bartoszp1992/Spinner/doc/assembly/bottom.jpg

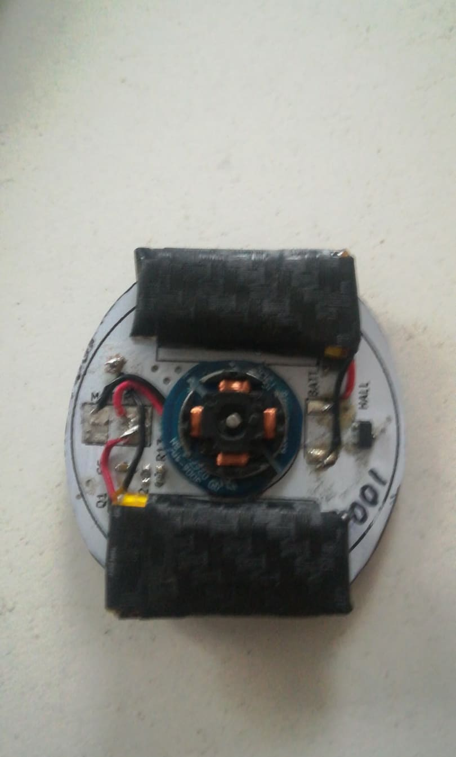
doc/assembly/bottom.jpg
