bartoszp1992/Spinner/doc/assembly/magnets.jpg

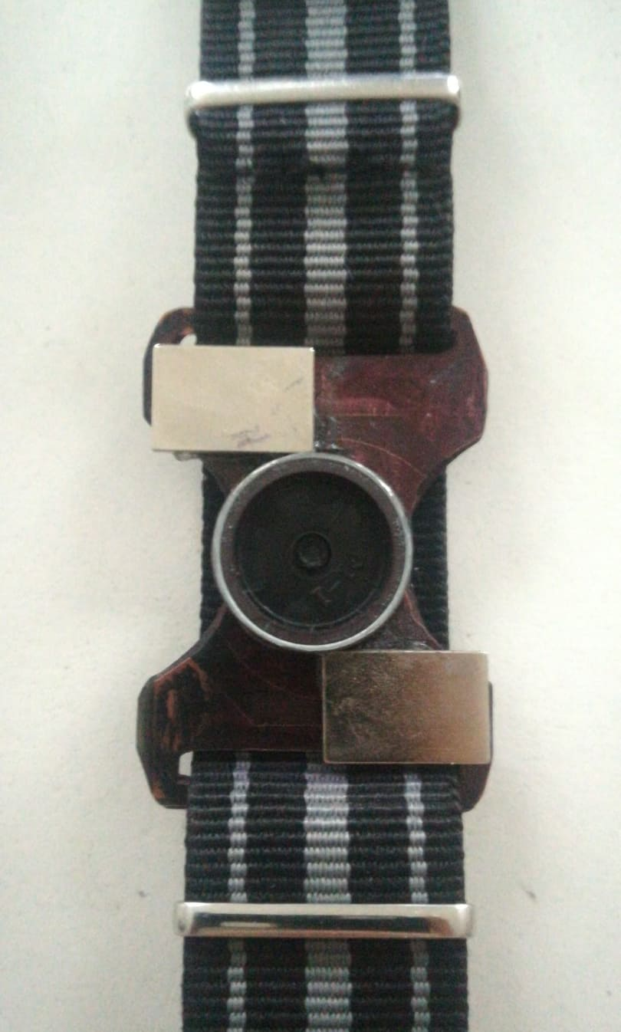
doc/assembly/magnets.jpg
