bartoszp1992/Spinner/doc/pcb/synchro mk2/synchro_mk2.step

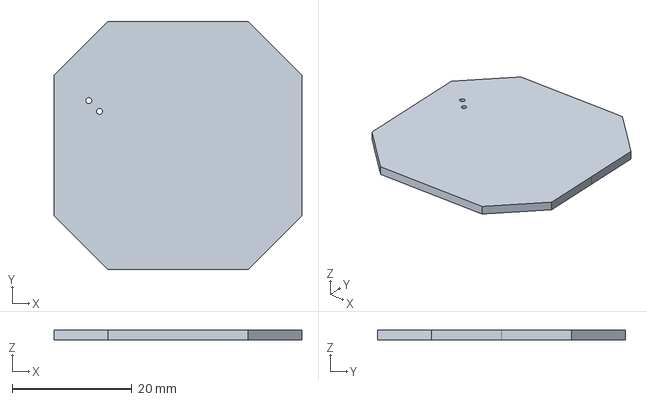
[picture p3: CAD file, 2019-12-25]
doc/pcb/synchro mk2/synchro_mk2.step
41.4 x 41.4 x 1.60 mm
