bartoszp1992/Spinner/doc/case/OLD/V1/base/base.FCStd

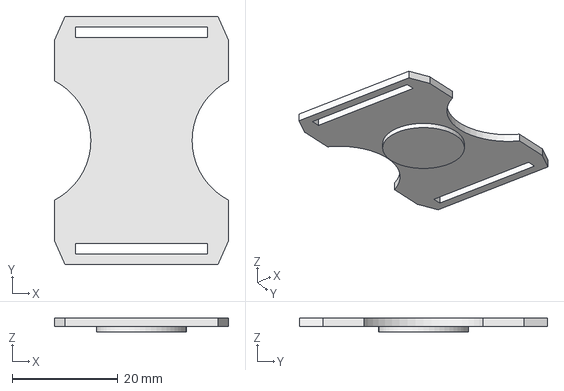
[picture p4: CAD file, 2019-12-29, an earlier design]
doc/case/OLD/V1/base/base.FCStd
33.0 x 47.0 x 2.60 mm
