bartoszp1992/Spinner/doc/case/OLD/V1/cage/cage.FCStd

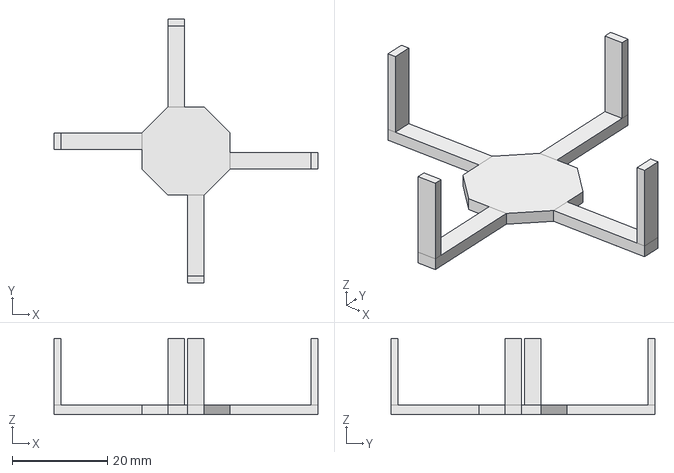
[picture p5: CAD file, 2019-12-29, an earlier design]
doc/case/OLD/V1/cage/cage.FCStd
55.5 x 55.5 x 16.0 mm
