bartoszp1992/Spinner/doc/case/OLD/V1/output/base.stl

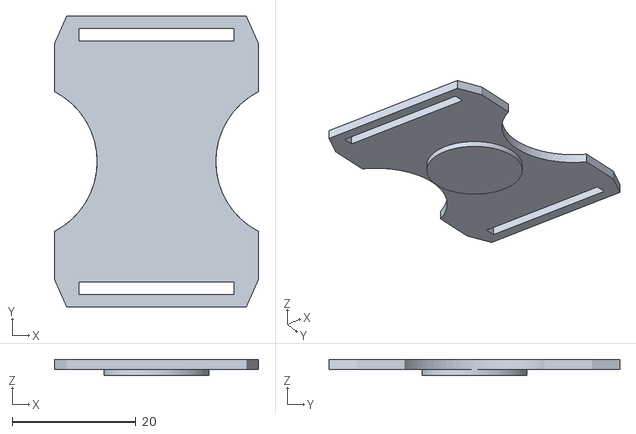
[picture p6: CAD file, 2019-12-29, an earlier design]
doc/case/OLD/V1/output/base.stl
33.0 x 47.0 x 2.60
