bartoszp1992/Spinner/doc/case/OLD/V1/ring/ring.FCStd

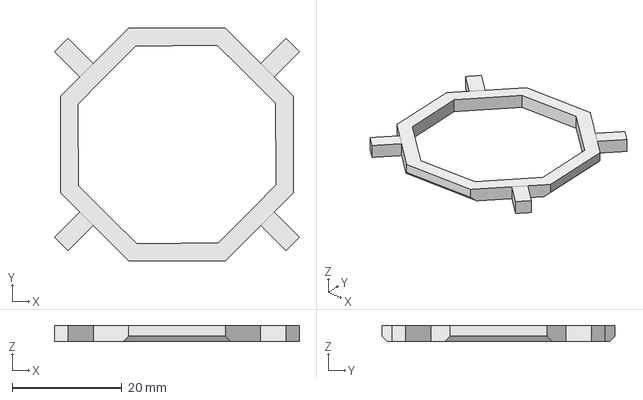
[picture p7: CAD file, 2019-12-29, an earlier design]
doc/case/OLD/V1/ring/ring.FCStd
44.7 x 42.5 x 3.00 mm
