bartoszp1992/Spinner/doc/case/OLD/V2/cage/cage.FCStd

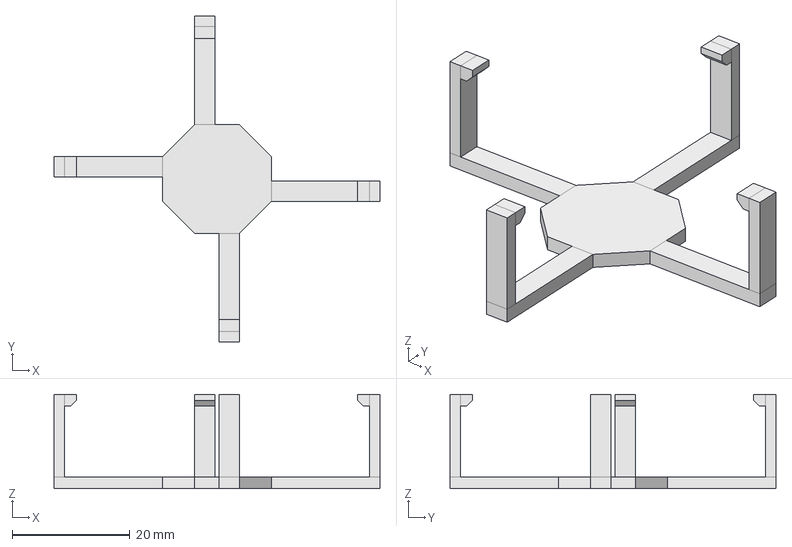
[picture p8: CAD file, 2020-02-08, an earlier design]
doc/case/OLD/V2/cage/cage.FCStd
55.5 x 55.5 x 16.0 mm
