bartoszp1992/Spinner/doc/pcb/OLD/synchro2/base.step

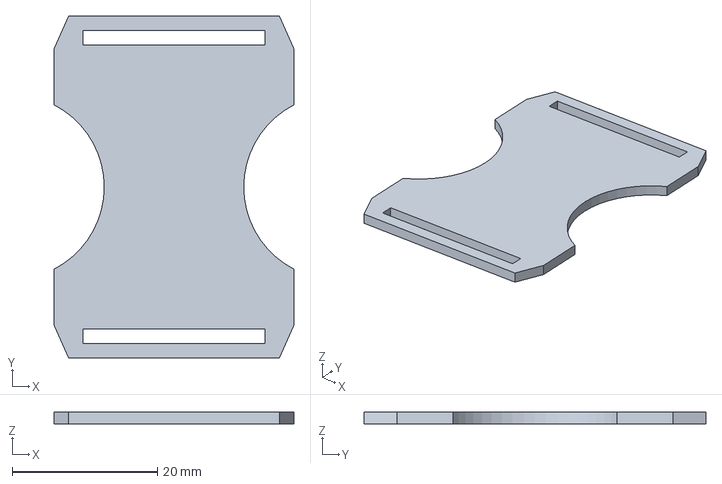
[picture p9: CAD file, 2019-12-25, an earlier design]
doc/pcb/OLD/synchro2/base.step
33.0 x 47.0 x 1.60 mm
