bartoszp1992/Spinner/(list of files, cad)

Other CAD files:
doc/case/OLD/V2/output/cage.stl
doc/case/OLD/V2/ring/ring.FCStd
doc/case/OLD/V1/output/ring.stl
doc/case/OLD/V2/output/ring.stl
doc/case/OLD/V1/output/cage.stl
doc/case/OLD/V1/ring/ring.stl
doc/case/OLD/V2/ring/ring.stl
doc/case/OLD/V3/ring/ring-F_SilkS.dxf
doc/pcb/OLD/synchro2/export/3d/base.step
doc/pcb/OLD/synchro2/export/3d/synchro2.step
doc/pcb/OLD/synchro2/export/synchro2.step
