bartoszp1992/Spinner/doc/pcb/synchro mk2/synchro_mk2.kicad_pcb

## KiCad design doc/pcb/synchro mk2/synchro_mk2.kicad_pcb (2021-09-27)

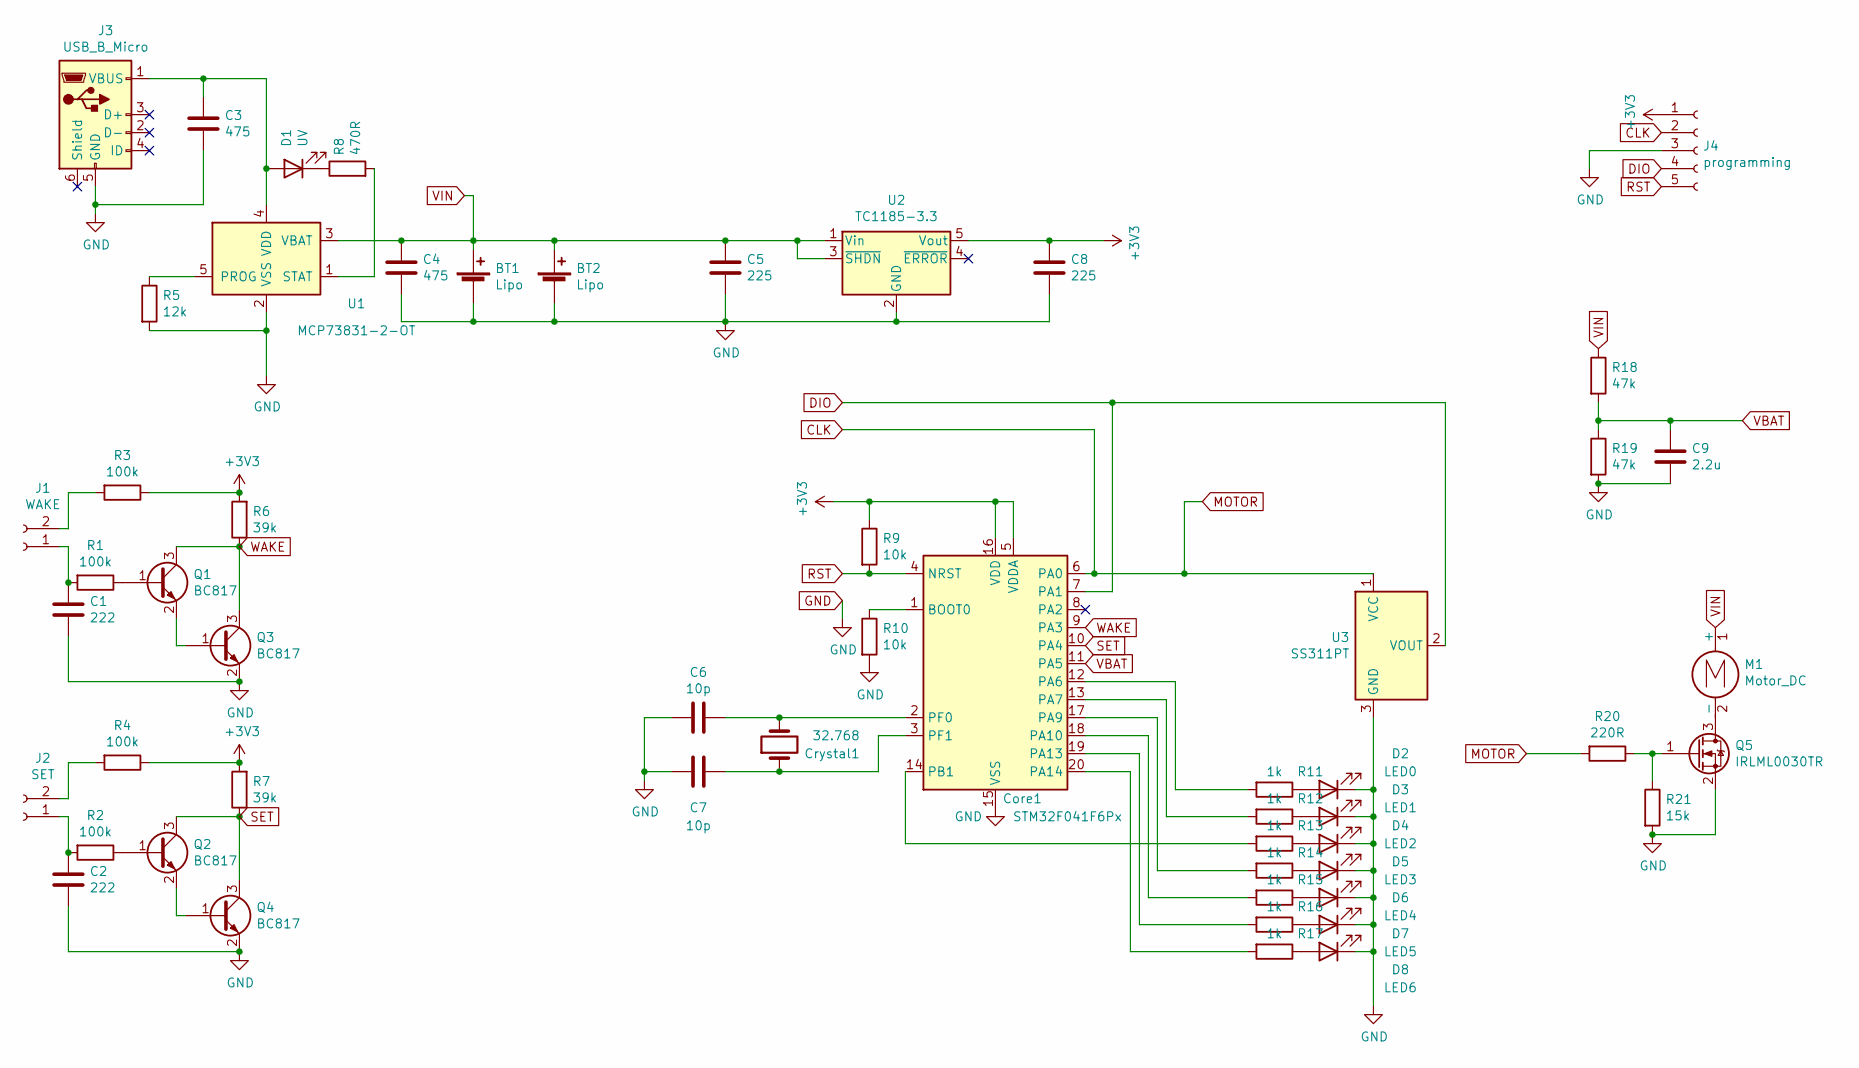
[picture p10: schematic synchro_mk2.sch]

Parts:
BT1, BT2: Lipo; R_2010_5025Metric
C1, C2: 222; C_0603_1608Metric
C3, C4: 475; C_0603_1608Metric
C5, C8: 225; C_0603_1608Metric
C6, C7: 10p; C_0603_1608Metric
C9: 2.2u; C_0603_1608Metric
Core1: STM32F041F6Px; TSSOP-20_4.4x6.5mm_P0.65mm
Crystal1: 32.768; Crystal_DS26_D2.0mm_L6.0mm_Horizontal
D1: UV; D_0603_1608Metric
D2: LED0; LED_0603_1608Metric
D3: LED1; LED_0603_1608Metric
D4: LED2; LED_0603_1608Metric
D5: LED3; LED_0603_1608Metric
D6: LED4; LED_0603_1608Metric
D7: LED5; LED_0603_1608Metric
D8: LED6; LED_0603_1608Metric
J1: WAKE; touchplate
J2: SET; touchplateS
J3: USB_B_Micro; USB_Micro-B_Molex_47346-0001
J4: programming; PinHeader_1x05_P1.27mm_Vertical
M1: Motor_DC; R_1206_3216Metric
Q1, Q2, Q3, Q4: BC817; SOT-23
Q5: IRLML0030TR; SOT-23
R1, R2, R3, R4: 100k; R_0603_1608Metric
R5: 12k; R_0603_1608Metric
R6, R7: 39k; R_0603_1608Metric
R8: 470R; R_0603_1608Metric
R9, R10: 10k; R_0603_1608Metric
R11, R12, R13, R14, R15, R16, R17: 1k; R_0603_1608Metric
R18, R19: 47k; R_0603_1608Metric
R20: 220R; R_0603_1608Metric
R21: 15k; R_0603_1608Metric
U1: MCP73831-2-OT; SOT-23-5
U2: TC1185-3.3; SOT-23-5
U3: SS311PT; SOT-23

Connections:
+3V3: C8.1, Core1.5 (VDDA), Core1.16 (VDD), J4.1, R3.1, R4.1, R6.2, R7.2, R9.1, U2.5 (Vout)
CLK: Core1.6 (PA0), J4.2, R20.2, U3.1 (VCC)
DIO: Core1.7 (PA1), J4.4, U3.2 (VOUT)
GND: BT1.2 (-), BT2.2 (-), C1.2, C2.2, C3.2, C4.2, C5.2, C6.2, C7.2, C8.2, C9.2, Core1.15 (VSS), D2.1 (K), D3.1 (K), D4.1 (K), D5.1 (K), D6.1 (K), D7.1 (K), D8.1 (K), J3.5 (GND), J4.3, Q3.2 (E), Q4.2 (E), Q5.2 (S), R5.2, R10.2, R19.2, R21.2, U1.2 (VSS), U2.2 (GND), U3.3 (GND)
unnamed: C1.1, J1.1, R1.2
unnamed: C2.1, J2.1, R2.2
unnamed: C3.1, D1.2 (A), J3.1 (VBUS), U1.4 (VDD)
unnamed: C6.1, Core1.2 (PF0), Crystal1.2
unnamed: C7.1, Core1.3 (PF1), Crystal1.1
unnamed: Core1.1 (BOOT0), R10.1
unnamed: Core1.12 (PA6), R11.2
unnamed: Core1.13 (PA7), R12.2
unnamed: Core1.14 (PB1), R13.2
unnamed: Core1.17 (PA9), R14.2
unnamed: Core1.18 (PA10), R15.2
unnamed: Core1.19 (PA13), R16.2
unnamed: Core1.20 (PA14), R17.2
unnamed: D1.1 (K), R8.1
unnamed: D2.2 (A), R11.1
unnamed: D3.2 (A), R12.1
unnamed: D4.2 (A), R13.1
unnamed: D5.2 (A), R14.1
unnamed: D6.2 (A), R15.1
unnamed: D7.2 (A), R16.1
unnamed: D8.2 (A), R17.1
unnamed: J1.2, R3.2
unnamed: J2.2, R4.2
unnamed: M1.2 (-), Q5.3 (D)
unnamed: Q1.1 (B), R1.1
unnamed: Q1.2 (E), Q3.1 (B)
unnamed: Q2.1 (B), R2.1
unnamed: Q2.2 (E), Q4.1 (B)
unnamed: Q5.1 (G), R20.1, R21.1
unnamed: R5.1, U1.5 (PROG)
unnamed: R8.2, U1.1 (STAT)
RST: Core1.4 (NRST), J4.5, R9.2
SET: Core1.10 (PA4), Q2.3 (C), Q4.3 (C), R7.1
VBAT: C9.1, Core1.11 (PA5), R18.2, R19.1
VIN: BT1.1 (+), BT2.1 (+), C4.1, C5.1, M1.1 (+), R18.1, U1.3 (VBAT), U2.1 (Vin), U2.3 (~SHDN)
WAKE: Core1.9 (PA3), Q1.3 (C), Q3.3 (C), R6.1

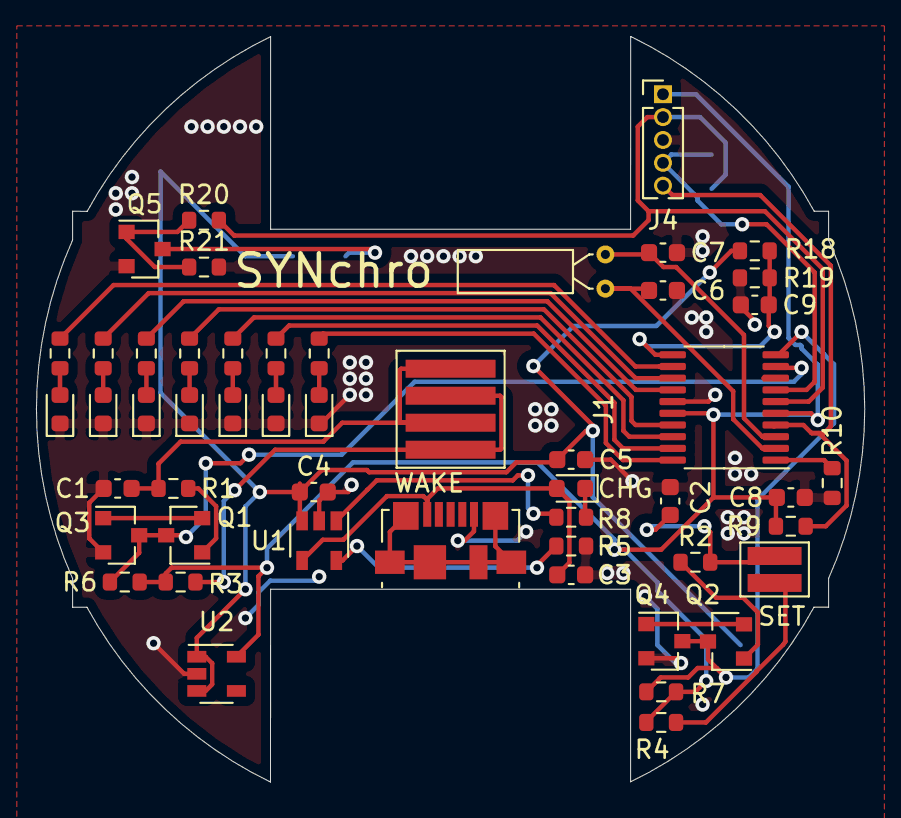
[picture p11: board synchro_mk2.kicad_pcb from above]

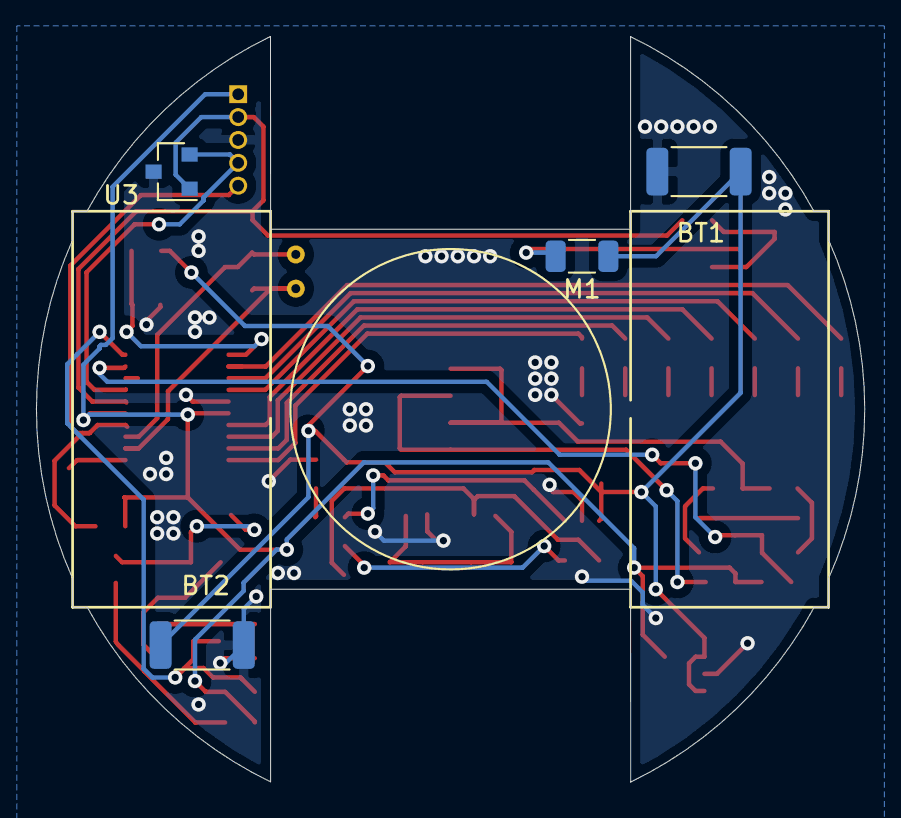
[picture p12: board synchro_mk2.kicad_pcb from below]

Board: 2 copper layers, 46.0 x 41.4 mm, 55 parts (4 on the bottom side), 40 nets.
