bartoszp1992/Spinner/doc/user manual/user manual.odt

Synchro mk5 instrukcja użytkownika

1. Uruchomienie

Kiedy zegarek ma zamontowany akumulator, po wciśnięciu przycisku WAKE diody powinny zacząć mrugać. Jeżeli nie ma żadnej reakcji – sprawdź napięcie na akumulatorze. PCM mógł go wyłączyć. W przypadku napięcia ponizej 2V – podłącz układ ładowarki i poczekaj aż akumulator się naładuje(zielona dioda)

2. Ustawianie godziny

Zegarek jest ustawiany w sposób binarny, po jednej cyfrze, w trybie dwunastogodzinnym.

Aby uruchomić tryb ustawień, wciśnij przycisk SET. Trzy mrugnięcia wszystkich diod sygnalizują wejście w tryb ustawiania pierwszej cyfry godzin:

00:00

Za pomocą przycisku WAKE ustaw pierwszą cyfrę- jest w czasie rzeczywistym pokazywana za pomocą diod, a następnie przyciskiem SET przejdź do ustawiania kolejnej cyfry.

Powtórz dla ustawienia jedności godzin, dziesiątek minut oraz jedności minut.

Wciśnięcie przycisku SET po ustawieniu ostatniej cyfry spowoduje przejśćie do trybu zerowania sekund. Diody będą zapalać i gasnąć z częstotliwością 1Hz. Wciśnij przycisk SET alby wyzerować sekundy. Trzy mrugnięcia sygnalizują wyjście z trybu ustawień.

Problemy:

Zegarek nie reaguje na wciskanie przycisków – sprawdź podłączenie akumulatorów

Zegarek włącza się, ale silnik nie startuje – sprawdź montaż klucza silnika

Zegarek włącza się, silnik startuje ale nie może wejść w tryb synchronizacji – sprawdź, czy magnesy są zamontowane w odwróconej polaryzacji; sprawdź montaż czujnika Halla.

Zegarek włącza się, silnik startuje, synchronizacja wyświetlacza jest poprawna, ale nie odmierza godziny- sprawdź montaż kryształu. Jeżeli jest poprawnie zamontowany, dolutuj kondensatory 10p w pustych miejscach.
