bartoszp1992/Spinner/doc/assembly/B.png

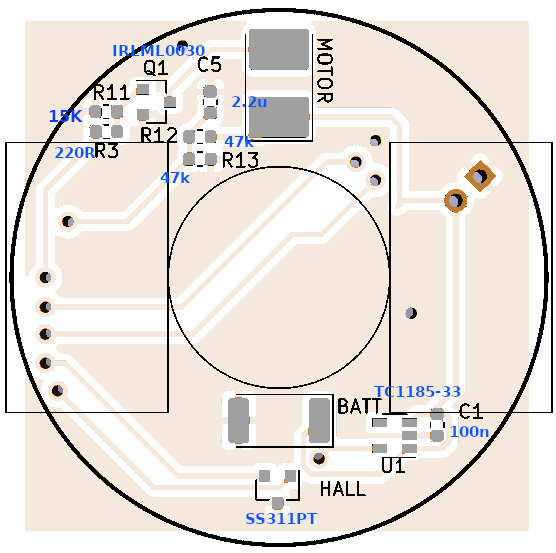
doc/assembly/B.png
