bartoszp1992/Spinner/doc/assembly/F.png

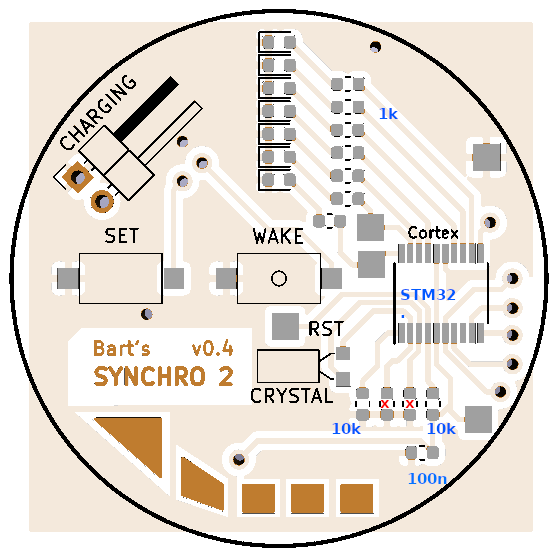
doc/assembly/F.png
