bartoszp1992/Spinner/Src/main.c

/* USER CODE BEGIN Header */
/**
 ******************************************************************************
 * @file           : main.c
 * @brief          : Main program body
 ******************************************************************************
 * @attention
 *
 * <h2><center>&copy; Copyright (c) 2019 STMicroelectronics.
 * All rights reserved.</center></h2>
 *
 * This software component is licensed by ST under BSD 3-Clause license,
 * the "License"; You may not use this file except in compliance with the
 * License. You may obtain a copy of the License at:
 *                        opensource.org/licenses/BSD-3-Clause
 *
 ******************************************************************************
 * Bart's Phantom
 *
 * PA1- added function for testing display, functions in separated file
 * PA2- more code comments, added function for display pointers
 * MS1- working clock, correct direct(clockwise :) )
 * MS2- working clock, working synchro
 * v0.1 pre alpha- ondemand start- not tested
 * v0.2 PA2 - tested on synchro board, working. Problem with synchro.
 * v0.2 PA3 - low power modes- first attempt
 * v0.3 PA4 - migrate to L041F6
 * v0.4 MS3 - milestone3:
 * 			setting time
 * 			low power modes
 * 			removed blinking
 *
 * v0.5
 * 			ondemand/force select
 *
 * v0.55
 * 			correct clock setting
 * 			hour pointer fix(now is dependent of minutes)
 *
 * v0.56
 * 			now columnTime are counted by sync interrupt only on start. If working, columnTime are only corrected in matrixDisplay() function.
 * 			added subsecond marker
 * 			sync interrupt time changed for 1 sec
 * 			added busy flag(but it isnt in use).
 * 			rpt is set to 0 after wakeup.

 * v0.57
 * 			fixed freeze bug on the sun.
 *
 * v0.58
 * 			shorted working time.
 *
 * v0.59
 * 			prepared for Synchro v0.2 board- disabled pullup for exti pin.
 * 			changed for hall sensor
 *
 *v0.6
 *			corrected counter clockwise mode- now just the matrix is shown swapped.
 *
 *v0.7
 *			added new matrixDisplah.c file for reverse columnTime counting.
 *
 *v0.71
 *			new idea for columnTimeCounting
 *
 *v0.72
 *			return to old columnTime counting
 *
 *v0.73
 *			auto sleep also in settings mode
 *			clock will not be reset if you enter settings mode :)
 *
 *v0.74
 *			added weak time- if rpt is below limit for selected time - clock will go to sleep
 *
 *v0.8
 *			batterystate measurement + force mode are now disabled, if state <10
 *
 *v1.0
 *			clock read only in displayMatrixCcw function, for fix shaking screen
 *			clock setting is now function, defined in rtc.h
 *			fixed working time in settings mode if force are active.
 *
 *v1.1
 *			corrections of working time, weak time, and min rpt.
 *
 *v1.2
 *			dynamic correction of columnTime, faster than lower rpt
 *
 * test
 *todo:
 *shaky screen- caused by matrixWriteTime(); Move this function to TIM2 interrupt.
 *counting columnTime is not enough presice. Where's the problem?
 *add temperature measurement
 *make secure- second hour digit must be set to - when first was set above 0.
 *hour will be reset at clock settings.
 *too short hour pointer between 0 and 1.

 currents:
 stop mode- 64uA

 Battery lifetime:
 cells: 2x lipo 120mAh
 30sec runs: 180
 idle: 150 days
 force working: 1h30'
 charging: 250mA / 1h
 */
/* USER CODE END Header */

/* Includes ------------------------------------------------------------------*/
#include "main.h"

/* USER CODE BEGIN Includes */
#include "matrixDisplay.h"
#include "rtc.h"
#include "adc.h"

/* USER CODE END Includes */

ADC_HandleTypeDef hadc;

RTC_HandleTypeDef hrtc;

TIM_HandleTypeDef htim2;

void SystemClock_Config(void);
static void MX_GPIO_Init(void);
static void MX_RTC_Init(void);
static void MX_TIM2_Init(void);
static void MX_ADC_Init(void);
/**
 * @brief  The application entry point.
 * @retval int
 */
int main(void) {
	/* MCU Configuration--------------------------------------------------------*/

	/* Reset of all peripherals, Initializes the Flash interface and the Systick. */
	HAL_Init();

	/* Configure the system clock */
	SystemClock_Config();

	/* Initialize all configured peripherals */
	MX_GPIO_Init();
	MX_RTC_Init();
	MX_TIM2_Init();
	MX_ADC_Init();
	/* USER CODE BEGIN 2 */
	matrixDisplayInit();
	adcInit();

	/* USER CODE END 2 */

	/* Infinite loop */
	/* USER CODE BEGIN WHILE */
	while (1) {

		//SECTION 0 - display mode

		if (mode == 1) {
			HALL_ON; //turn on interrupter ant vent
			if (rpt >= minRpt) { //if rpt are enough, run display
				matrixDisplayCcw();
			} else { //if watch still accelerates, show splash
				matrixSplash(50);
			}

		}

		if (mode == 0) { //this mode are set by sync interrupt, when workingCounter are bigger than set(when displaying time is up).
			HALL_OFF; //turn off interrupter and vent
			ALL_OFF
			;
			HAL_PWR_EnterSTOPMode(PWR_MAINREGULATOR_ON, PWR_STOPENTRY_WFI); //go to stop mode :)
		}

		//SECTION 1 - //force/ondemand mode select - press SET and WAKE parallel
		if (WAKE) {

			HAL_Delay(contacts);

			if (SET && WAKE) {
				for (uint8_t i = 0; i < 6; i++) { //settings enter splash- blink all 3 times
					toggleAll();
					HAL_Delay(100);
				}

				if (forceMode == 1) {
					forceMode = 0;
				} else if (forceMode == 0) {
					forceMode = 1;
				}

				HAL_Delay(contacts);
			}
		}

		//SECTION 2 - CLOCK SETTING //press SET only
		clockSetting();

		/* USER CODE END WHILE */

		/* USER CODE BEGIN 3 */
	}
	/* USER CODE END 3 */
}

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
