bartoszp1992/Spinner/Spinner.ioc

Mcu.UserName=STM32L041F6Px
PA0-CK_IN.GPIO_Label=HALL
PA0-CK_IN.Signal=GPIO_Output
PA1.GPIO_Label=EXTI
PA1.Signal=GPXTI1
PA10.GPIO_Label=L4
PA10.Signal=GPIO_Output
PA13.GPIO_Label=L5
PA13.Signal=GPIO_Output
PA14.GPIO_Label=L6
PA14.Signal=GPIO_Output
PA3.GPIO_Label=WAKE
PA3.Signal=GPXTI3
PA4.GPIO_Label=SET
PA4.Signal=GPXTI4
PA5.GPIO_Label=VBAT
PA5.Signal=ADC_IN5
PA6.GPIO_Label=L0
PA6.Signal=GPIO_Output
PA7.GPIO_Label=L1
PA7.Signal=GPIO_Output
PA9.GPIO_Label=L3
PA9.Signal=GPIO_Output
PB1.GPIO_Label=L2
PB1.Signal=GPIO_Output
PC14-OSC32_IN.Signal=RCC_OSC32_IN
PC15-OSC32_OUT.Signal=RCC_OSC32_OUT
