bartoszp1992/Spinner/Inc/main.h

#define HALL_Pin GPIO_PIN_0
#define HALL_GPIO_Port GPIOA
#define EXTI_Pin GPIO_PIN_1
#define EXTI_GPIO_Port GPIOA
#define EXTI_EXTI_IRQn EXTI0_1_IRQn
#define WAKE_Pin GPIO_PIN_3
#define WAKE_GPIO_Port GPIOA
#define WAKE_EXTI_IRQn EXTI2_3_IRQn
#define SET_Pin GPIO_PIN_4
#define SET_GPIO_Port GPIOA
#define SET_EXTI_IRQn EXTI4_15_IRQn
#define VBAT_Pin GPIO_PIN_5
#define VBAT_GPIO_Port GPIOA
#define L0_Pin GPIO_PIN_6
#define L0_GPIO_Port GPIOA
#define L1_Pin GPIO_PIN_7
#define L1_GPIO_Port GPIOA
#define L2_Pin GPIO_PIN_1
#define L2_GPIO_Port GPIOB
#define L3_Pin GPIO_PIN_9
#define L3_GPIO_Port GPIOA
#define L4_Pin GPIO_PIN_10
#define L4_GPIO_Port GPIOA
#define L5_Pin GPIO_PIN_13
#define L5_GPIO_Port GPIOA
#define L6_Pin GPIO_PIN_14
#define L6_GPIO_Port GPIOA
