bartoszp1992/Spinner/(commit log)

2019-09-11 fixed freeze in the sun
    [synchro2.sch]
2019-09-13 shorted working time to 20s
    [main.c, matrixDisplay.c]
2019-09-20 hall sensor, updated scheme and pcb
    [synchro2.kicad_pcb, synchro2.sch]
2019-09-21 new pcb
    [synchro2.kicad_pcb]
2019-09-21 added ring, corrected counterclockwise mode
    [ring.kicad_pcb]
2019-09-22 added new version of matrixDisplay, better RING(PCB)
    [ring.kicad_pcb, synchro2.kicad_pcb, synchro2.step, timersheet.ods]
2019-09-22 added connections for ADC
    [ring.kicad_pcb, synchro2.kicad_pcb, synchro2.sch]
2019-09-23 again old file
    [timersheet.ods]
2019-09-27 added cage pcb
    [cage.kicad_pcb]
2019-09-30 added adc version
    [synchro2.kicad_pcb, synchro2.sch, timersheet.ods]
2019-09-30 adc initial
2019-09-30 adc stucks
2019-10-04 v0.4 pcb
    [mk.kicad_pcb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]
2019-10-04 +gerber files
    [synchro2-B_Cu.gbr, synchro2-B_Mask.gbr, synchro2-B_Paste.gbr, synchro2-B_SilkS.gbr, synchro2-Edge_Cuts.gbr, synchro2-F_Cu.gbr, synchro2-F_Mask.gbr, synchro2-F_Paste.gbr]
2019-10-09 BOM update
    [synchro2.kicad_pcb, synchro2.sch]
2019-10-11 added base, correct stabiliser name
    [RotaryClockBase-v1.stl, synchro2.sch]
2019-10-21 little corrections
    [base.kicad_pcb, base.step, cage.kicad_pcb, case.kicad_pcb, ring.kicad_pcb, synchro2.step]
2019-10-31 exported clock base
    [base.kicad_pcb]
2019-11-05 mechanical corrections
    [1st series.ods, RotaryClockBase-v1.stl, base.kicad_pcb]
2019-11-11 bom updated with cells model
2019-12-23 small corrections
    [1st series.ods]
2019-12-25 case initial
    [PCB.FCStd, base.FCStd, base.step, battery.FCStd, motor.FCStd, ring.FCStd, ring.stl, synchro2.kicad_pcb]
2019-12-29 added case
    [PCB.FCStd, base.FCStd, base.stl, battery.FCStd, cage.FCStd, cage.stl, motor.FCStd, ring.FCStd]
2020-01-04 separate folder for 1st verison case
    [base.FCStd, base.stl, cage.FCStd, cage.stl, ring.FCStd, ring.stl]
2020-05-23 new v3 case
    [base-Edge_Cuts.dxf, base.kicad_pcb, base.st.stl, base.step, base.stl, ring.kicad_pcb, ring.step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]
2020-05-24 new case
    [base.kicad_pcb, ring.kicad_pcb]
2020-05-29 dxf export
    [ring-Edge_Cuts.dxf]
2020-07-29 new design
    [ChronoMatic.kicad_pcb, ChronoMatic.sch, base.kicad_pcb, base.step, synchro2.kicad_pcb, synchro2.sch]
2020-10-18 small pcb corrections
    [base-Edge_Cuts.dxf, base.kicad_pcb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]
2021-09-27 new board
    [1st series.ods, ChronoMatic.kicad_pcb, ChronoMatic.sch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]
