bartoszp1992/Spinner/(notices)

Notices in the files:
Inc/main.h:
(C) COPYRIGHT STMicroelectronics *****END OF FILE
